TinkerYpsi/EnviroLogger/EnviroLogger.kicad_pcb

## KiCad design EnviroLogger.kicad_pcb (2019-02-18)

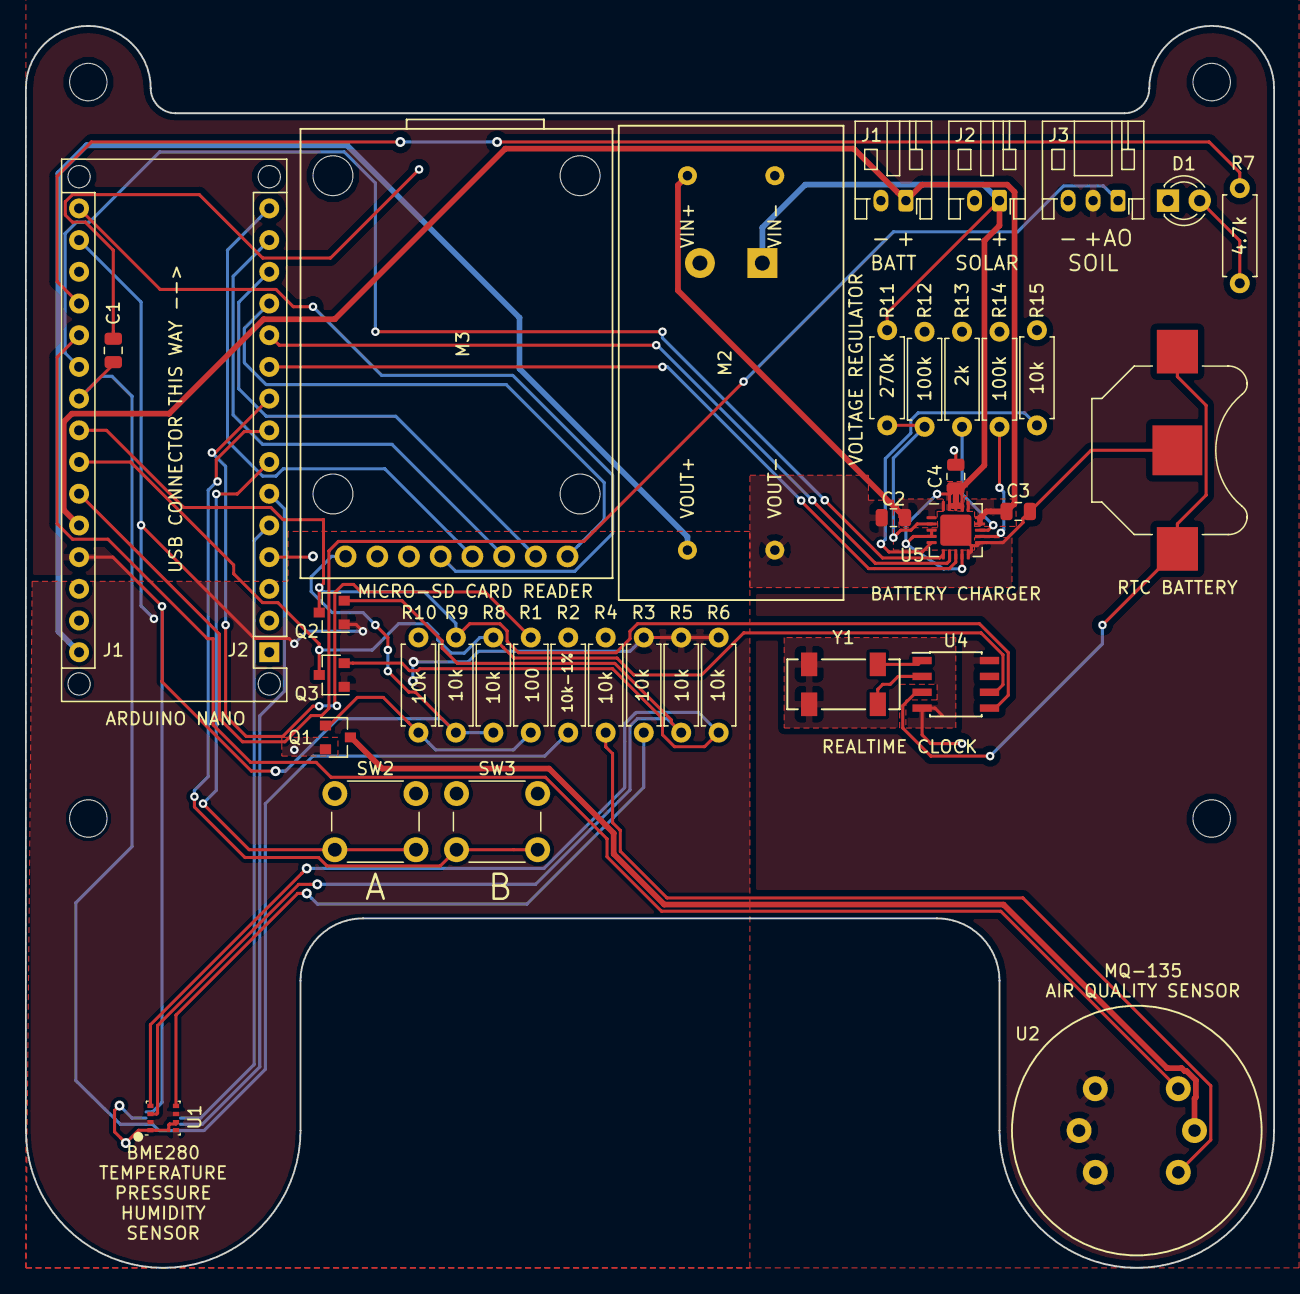
[picture p1: board EnviroLogger.kicad_pcb from above]

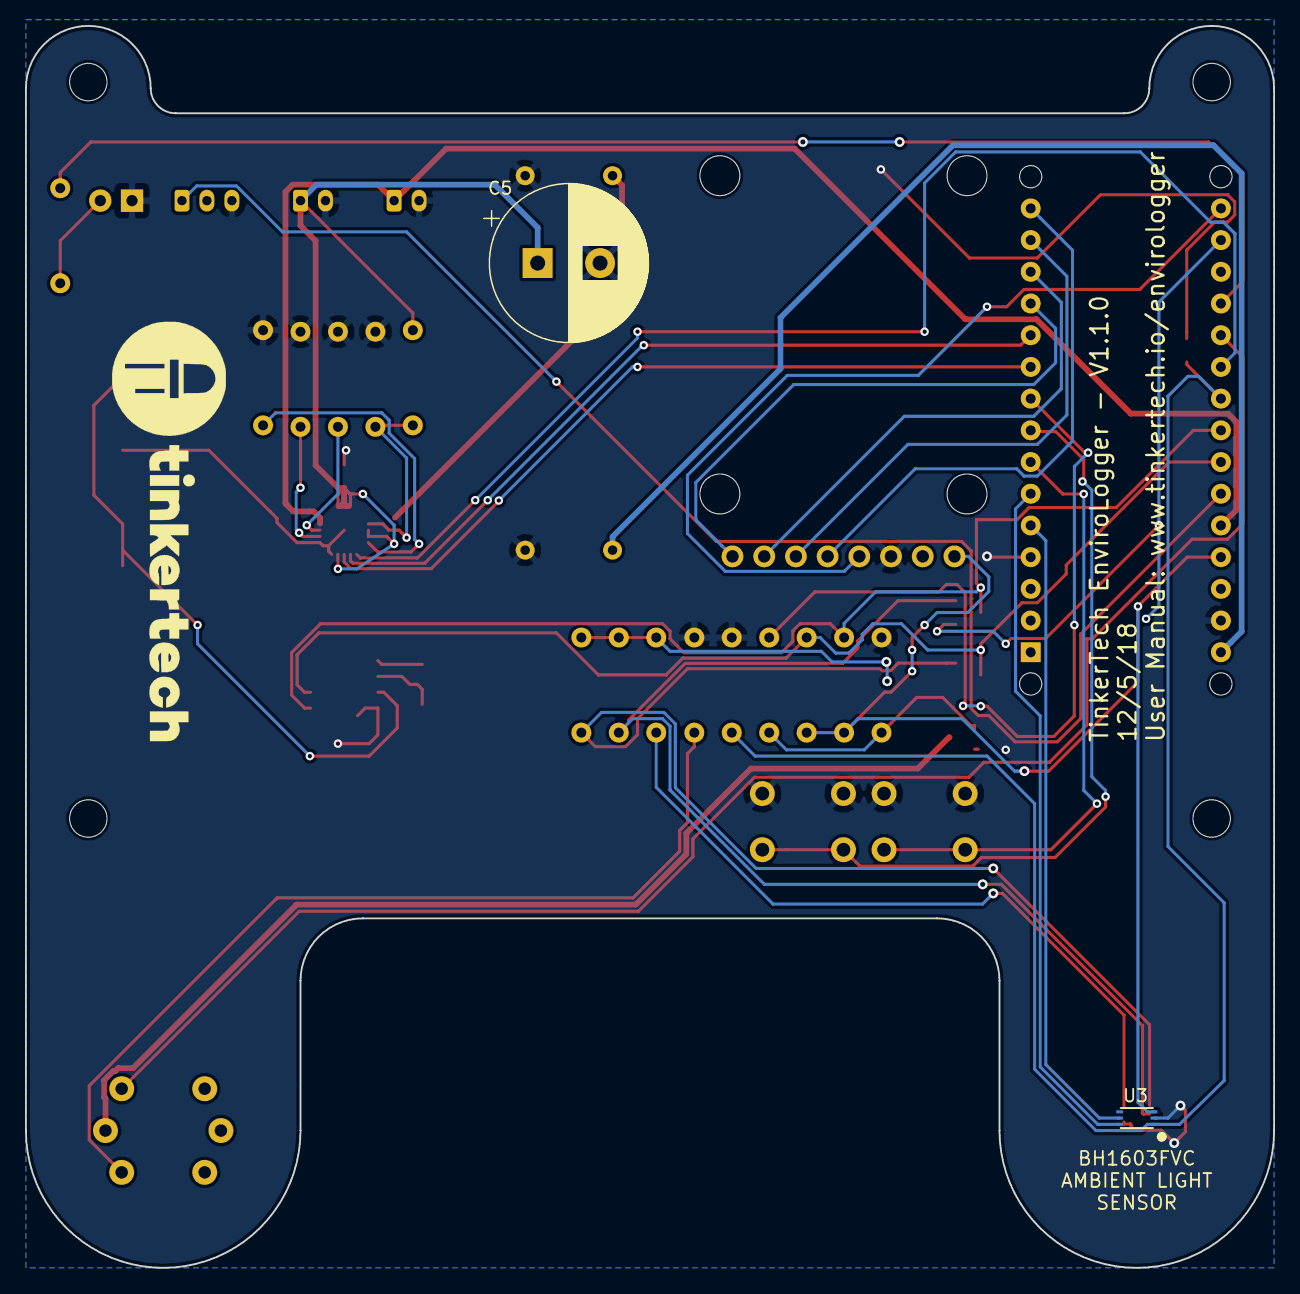
[picture p2: board EnviroLogger.kicad_pcb from below]

Board: 2 copper layers, 100.0 x 99.5 mm, 44 parts (3 on the bottom side), 40 nets.

Parts:
A1: Arduino_Nano_v3.x; Arduino_Nano_WithMountingHoles
BT1: Battery_Cell; BatteryHolder_Keystone_3000_1x12mm
C1, C2, C3, C4: 10uF; C_0805_2012Metric
C5: 4700uF; CP_Radial_D12.5mm_P5.00mm
D1: LED; LED_D3.0mm
H1, H2, H3, H4: MountingHole; MountingHole_3mm
J1, J2: Conn_01x02_Male; JST_PH_S2B-PH-K_1x02_P2.00mm_Horizontal
J3: Conn_01x03_Male; JST_PH_S3B-PH-K_1x03_P2.00mm_Horizontal
M2: MT3608_Boost_Regulator
M3: RobotDyn_MicroSD_Card_Reader
Q1: DMN6140L; SOT-23
Q2, Q3: BSS138; SOT-23
R1: 100; R_Axial_DIN0207_L6.3mm_D2.5mm_P7.62mm_Horizontal
R2: 10k-1%; R_Axial_DIN0207_L6.3mm_D2.5mm_P7.62mm_Horizontal
R3, R4, R5, R6, R8, R9, R10, R15: 10k; R_Axial_DIN0207_L6.3mm_D2.5mm_P7.62mm_Horizontal
R7: 4.7k; R_Axial_DIN0207_L6.3mm_D2.5mm_P7.62mm_Horizontal
R11: 270k; R_Axial_DIN0207_L6.3mm_D2.5mm_P7.62mm_Horizontal
R12, R14: 100k; R_Axial_DIN0207_L6.3mm_D2.5mm_P7.62mm_Horizontal
R13: 2k; R_Axial_DIN0207_L6.3mm_D2.5mm_P7.62mm_Horizontal
SLK1: TT_Logo; TinkerTech-Logo_34.4x10mm_SilkScreen
SW2, SW3: SW_Push; SW_PUSH_6mm_H4.3mm
U1: BME280; Bosch_LGA-8_2.5x2.5mm_P0.65mm_ClockwisePinNumbering
U2: MQ-135
U3: BH1603FVC; WSOF6
U4: DS1307ZN+; SOIC-8_3.9x4.9mm_P1.27mm
U5: MCP73871; QFN-20-1EP_4x4mm_P0.5mm_EP2.5x2.5mm
Y1: Crystal_GND23; Crystal_SMD_CardinalComponents_CPFB-4Pin_8.7x3.7mm

Connections:
+3V3: A1.17, Q2.1, Q3.1, R3.1, R5.2, R6.2, U1.2, U1.6, U1.8
+5V: A1.27, J3.2, M3.8, R8.2, R9.2, U2.1, U2.2, U2.3, U3.3, U4.8
BATT+: A1.26, C3.1, J1.1, U5.14, U5.15, U5.16
BUTTON_1: A1.7, SW2.2
BUTTON_2: A1.8, SW3.2
CARD_DETECT: A1.12, M3.1
CHARGER_VOUT: C2.1, M2.4, U5.1, U5.20
GAIN_CTR_1: A1.5, U3.5
GAIN_CTR_2: A1.6, U3.6
GND: A1.4, A1.29, BT1.2, C1.2, C2.2, C3.2, C4.2, C5.2, D1.1, J1.2, J2.2, J3.3, M2.2, M2.3, M3.6, Q1.2, R2.2, R4.2, R10.1, R12.1, R13.1, R14.1, R15.2, SW2.1, SW3.1, U1.1, U1.7, U3.2, U4.4, U5.10, U5.11, U5.21, Y1.2, Y1.3
INDICATOR_LED: A1.19, R7.1
LIGHT_SENSE_CURRENT: A1.22, C1.1, R2.1, U3.1
MQ-150-GND: Q1.3, U2.5
MQ-150_OUT: A1.20, U2.6
MQ-150_Toggle: A1.9, R1.2
NANO_VIN: A1.30, M2.1
unnamed: BT1.1, U4.3
unnamed: D1.2, R7.2
unnamed: Q1.1, R1.1, R10.2
unnamed: R3.2, U1.5
unnamed: R4.1, U2.4
unnamed: R11.1, R12.2, U5.2
unnamed: R13.2, U5.13
unnamed: R14.2, U5.12
unnamed: R15.1, U5.5
unnamed: U4.1, Y1.1
unnamed: U4.2, Y1.4
SCK_3.3V: Q3.2, R6.1, U1.4
SCK_5V: A1.24, Q3.3, R8.1, U4.6
SDA_3.3V: Q2.2, R5.1, U1.3
SDA_5V: A1.23, Q2.3, R9.1, U4.5
SOIL_MOISTURE_OUT: A1.25, J3.1
SOLAR+: C4.1, C5.1, J2.1, R11.2, U5.3, U5.4, U5.9, U5.17, U5.18, U5.19
SPI_CLK: A1.16, M3.5
SPI_MISO: A1.15, M3.4
SPI_MOSI: A1.14, M3.3
SPI_SS: A1.13, M3.2
STAT1: A1.10, U5.8
STAT2: A1.11, U5.7
~PG: A1.21, U5.6
