TinkerYpsi/EnviroLogger/backup.kicad_pcb

## KiCad design backup.kicad_pcb (2018-11-13)

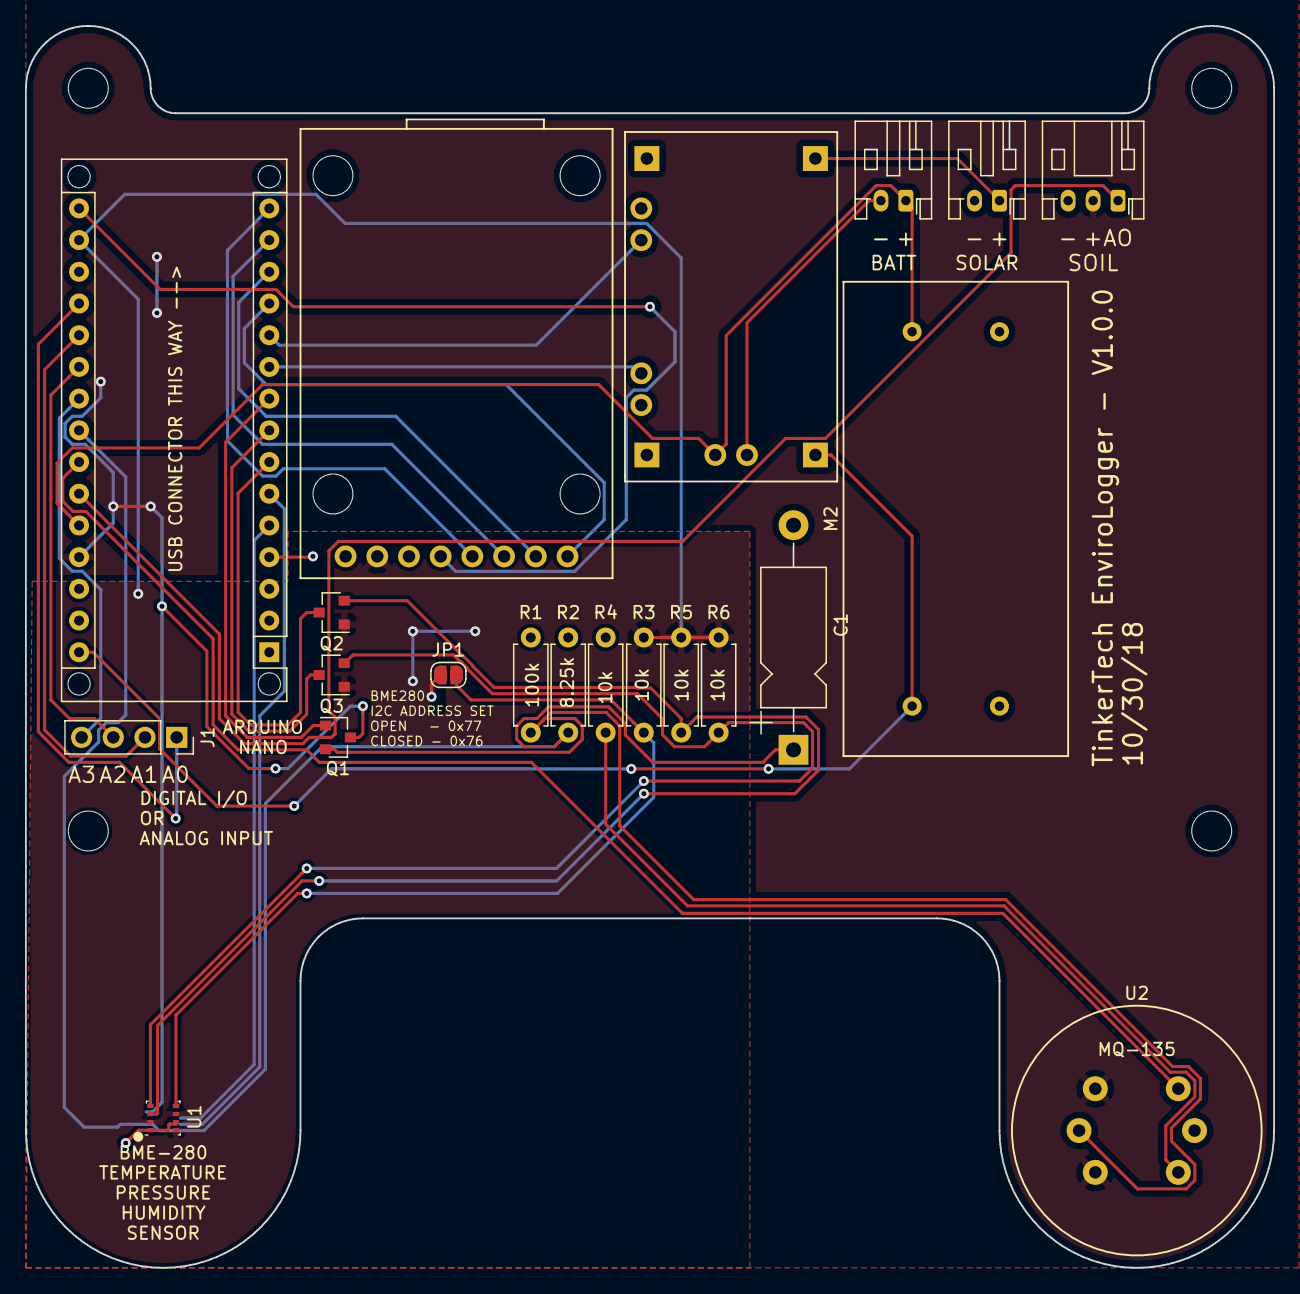
[picture p3: board backup.kicad_pcb from above]

Board: 2 copper layers, 100.0 x 99.5 mm, 22 parts (1 on the bottom side), 31 nets.

Parts:
A1: Arduino_Nano_v3.x; Arduino_Nano_WithMountingHoles
C1: 12uF; CP_Axial_L11.0mm_D5.0mm_P18.00mm_Horizontal
J1: Conn_01x04_Female; PinSocket_1x04_P2.54mm_Vertical
J3: Conn_01x03_Male; JST_PH_S3B-PH-K_1x03_P2.00mm_Horizontal
J4, J5: Conn_01x02_Male; JST_PH_S2B-PH-K_1x02_P2.00mm_Horizontal
JP1: SolderJumper_2_Open; SolderJumper-2_P1.3mm_Open_RoundedPad1.0x1.5mm
M1: RobotDyn_Li-Ion_Charger_W-Protection
M2: MT3608_Boost_Regulator
M3: RobotDyn_MicroSD_Card_Reader
Q1, Q2, Q3: BSS138; SOT-23
R1: 100k; R_Axial_DIN0207_L6.3mm_D2.5mm_P7.62mm_Horizontal
R2: 8.25k; R_Axial_DIN0207_L6.3mm_D2.5mm_P7.62mm_Horizontal
R3, R4, R5, R6: 10k; R_Axial_DIN0207_L6.3mm_D2.5mm_P7.62mm_Horizontal
U1: BME280; Bosch_LGA-8_2.5x2.5mm_P0.65mm_ClockwisePinNumbering
U2: MQ-135
U3: BH1603FVC; WSOF6

Connections:
+3V3: A1.17, M3.7, Q2.1, Q3.1, R3.1, R5.2, R6.2, U1.2, U1.6, U1.8
+5V: A1.27, J3.2, Q1.3, U2.1, U2.3, U3.3
BATT+: A1.26, J4.1, M1.8, M2.4
BATT-: J4.2, M1.9
CARD_DETECT: A1.12, M3.1
CHG_ACTIVE: A1.10, M1.5
CHG_STBY: A1.11, M1.4
GAIN_CTR_1: A1.5, U3.5
GAIN_CTR_2: A1.6, U3.6
GND: A1.4, A1.29, C1.2, J3.3, J5.2, JP1.2, M1.2, M1.3, M1.6, M1.7, M2.2, M2.3, M3.6, R1.2, R2.2, R4.2, U1.1, U1.7, U2.5, U3.2
LIGHT_SENSE_CURRENT: A1.23, C1.1, R2.1, U3.1
MQ-150_OUT: A1.24, U2.6
MQ-150_Toggle: A1.9, Q1.1
NANO_VIN: A1.30, M1.10, M2.1
unnamed: A1.19, J1.1
unnamed: A1.20, J1.2
unnamed: A1.21, J1.3
unnamed: A1.22, J1.4
unnamed: JP1.1, R3.2, U1.5
unnamed: Q1.2, R1.1, U2.2
unnamed: R4.1, U2.4
SCK_3.3V: Q3.2, R6.1, U1.4
SCK_5V: A1.8, Q3.3
SDA_3.3V: Q2.2, R5.1, U1.3
SDA_5V: A1.7, Q2.3
SOIL_MOISTURE_OUT: A1.25, J3.1
SOLAR+: J5.1, M1.1
SPI_CLK: A1.16, M3.5
SPI_MISO: A1.15, M3.4
SPI_MOSI: A1.14, M3.3
SPI_SS: A1.13, M3.2
