TinkerYpsi/EnviroLogger/(commit log)

2018-11-14 Updated to V1.1.0
    Fixed many issues:
    - Battery polarity was reversed
    - I2C SDA and SCL were on the wrong Nano pins
    - Added missing pull-up resistor on 5V side of I2C level shifter
    - Added a real time clock to the design
    - Fixed boost regulator wiring
    - Changed MQ-135 control MOSFET to a part with much lower Rds(on) value.
    The original part was dropping almost 25% as much voltage as the sensor
    itself.
    - Changed MQ-135 control to low-side switch design
    [EnviroLogger.kicad_pcb, EnviroLogger.sch]
2018-12-05 Update to V1.0.2
    Fixed battery grounding issue
    [EnviroLogger.kicad_pcb, EnviroLogger.sch]
2019-02-18 Updated to V1.1.0
    Added solar charging circuitry
    [EnviroLogger.kicad_pcb, EnviroLogger.sch]
